ibitter/kedou-feeder/hardware/BOM_蝌蚪RS485飞达控制板_电路板单板.xlsx

Sheet: bom模板
 |  |  |  | Bill of Materials | BOM_蝌蚪RS485飞达控制板_电路板单板
 |  |  |  | Project Title： | 蝌蚪RS485飞达控制板
 |  |  |  | Variant:
 |  |  |  | Report Time： | 2026年11月10日 15:36:28
No. | Quantity | Comment | Designator | Footprint | Value | Manufacturer Part | Manufacturer | Supplier Part | Supplier | LCSC Price | Total
 | 2 | 100nF | C1, C2 | C0603 | 100nF | CL10B104KB8NNNC | SAMSUNG(三星) | C1591 | LCSC | 0.0441
 | 1 | 220uF | C3 | CAP-SMD_BD6.3-L6.6-W6.6-LS7.3-FD | 220uF | MA25V220M6X8 | JIERR(捷而瑞) | C46550464 | LCSC | 1.1074
 | 1 | 10uF | C4 | C0603 | 10uF | CL10A106MQ8NNNC | SAMSUNG(三星) | C1691 | LCSC | 0.0967
 | 1 | SM712-02HTG | D1 | SOT-23_L2.9-W1.3-P1.90-LS2.4-BR |  | SM712-02HTG | Littelfuse(美国力特) | C172881 | LCSC | 2.265
 | 1 | PZ254V-11-03P | H1 | HDR-TH_3P-P2.54-V-M_PZ254V-11-03P |  | PZ254V-11-03P | XFCN(兴飞) | C2937625 | LCSC | 0.1216
 | 1 | LAIL-PZ2.54-4P-L | H2 | CONN-TH_LAIL-PZ2.54-4P-L |  | LAIL-PZ2.54-4P-L | 莱联 | C54950602 | LCSC | 0.2215
 | 1 | LTST-C191KSKT | LED1 | LED0603-RD-YELLOW |  | LTST-C191KSKT | LITEON(光宝) | C125100 | LCSC | 0.1234
 | 1 | 10kΩ | R1 | R0603 | 10kΩ | RT0603BRD0710KL | YAGEO(国巨) | C95204 | LCSC | 0.184
 | 2 | 1kΩ | R2, R84 | R0603 | 1kΩ | FRC0603F1001TS | FOJAN(富捷) | C2907002 | LCSC | 0.0127
 | 1 | 1kΩ | R3 | R0603 | 1kΩ | RMC 0603 1K J N | Tyohm(幸亚电阻) | C5362357 | LCSC | 0.0198
 | 1 | 2kΩ | R76 | R0603 | 2kΩ | FRC0603F2001TS | FOJAN(富捷) | C2907022 | LCSC | 0.0118
 | 1 | TC-6615-5-260G | SW1 | SW-TH_4P-L7.5-W5.0-P4.50 |  | TC-6615-5-260G | HCTL(华灿天禄) | C2845270 | LCSC | 0.1769
 | 1 | AMS1117-3.3 | U1 | SOT-223-4_L6.5-W3.5-P2.30-LS7.0-BR |  | AMS1117-3.3 | UMW(友台半导体) | C347222 | LCSC | 0.2971
 | 1 | 04F414000 | U2 | CONN-SMD_04F414000 |  | 04F414000 | SAMZO(三佐) | C42402950 | LCSC | 4.88
 | 1 | STC8H8K64U-45I-SOP16 | U4 | SOP-16_L9.9-W3.9-P1.27-LS6.0-BL |  | STC8H8K64U-45I-SOP16 | STC | C18212990 | LCSC | 3.36
 | 1 | MAX3078EESA+T | U28 | SOIC-8_L4.9-W3.9-P1.27-LS6.0-BL |  | MAX3078EESA+T | ADI(亚德诺)/MAXIM(美信) | C40031 | LCSC | 32.04

Sheet: Field汇总
Project Title | 蝌蚪RS485飞达控制板
Borard Title | 蝌蚪RS485飞达控制板
Schematic Title | 原理图
PCB Title | 电路板单板
Variant Name
Total Quantity | 18
Report Time | 15:36:28
Report Date | 2026年11月10日
Report Date&Time | 2026年11月10日 15:36:28
File Name | BOM_蝌蚪RS485飞达控制板_电路板单板
Filter Option | Add into BOM:no;
