ibitter/kedou-feeder/hardware/蝌蚪飞达3D打印件.3mf

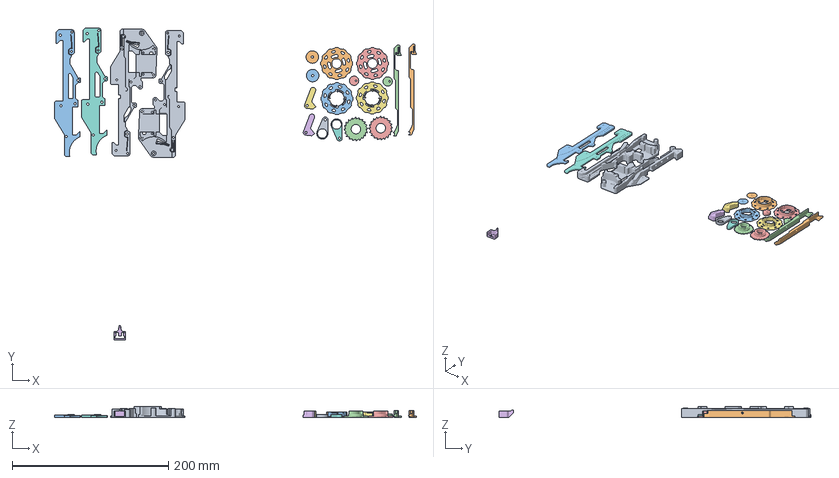
[picture p1: CAD file, 2026-11-13]
hardware/蝌蚪飞达3D打印件.3mf
463.3 x 398.9 x 14.0 mm
蝌蚪飞达stl文件.stl_9 x 2
蝌蚪飞达stl文件.stl_2 x 2
蝌蚪飞达stl文件.stl_4 x 2
蝌蚪飞达stl文件.stl_10
蝌蚪飞达stl文件.stl_3 x 2
蝌蚪飞达stl文件.stl_8 x 2
蝌蚪飞达stl文件.stl_5 x 2
蝌蚪飞达stl文件.stl_1 x 2
蝌蚪飞达stl文件.stl_6 x 2
蝌蚪飞达stl文件.stl_11 x 2
